OxfordUniRacing/BSPD_ECAD/BSPD.pdf

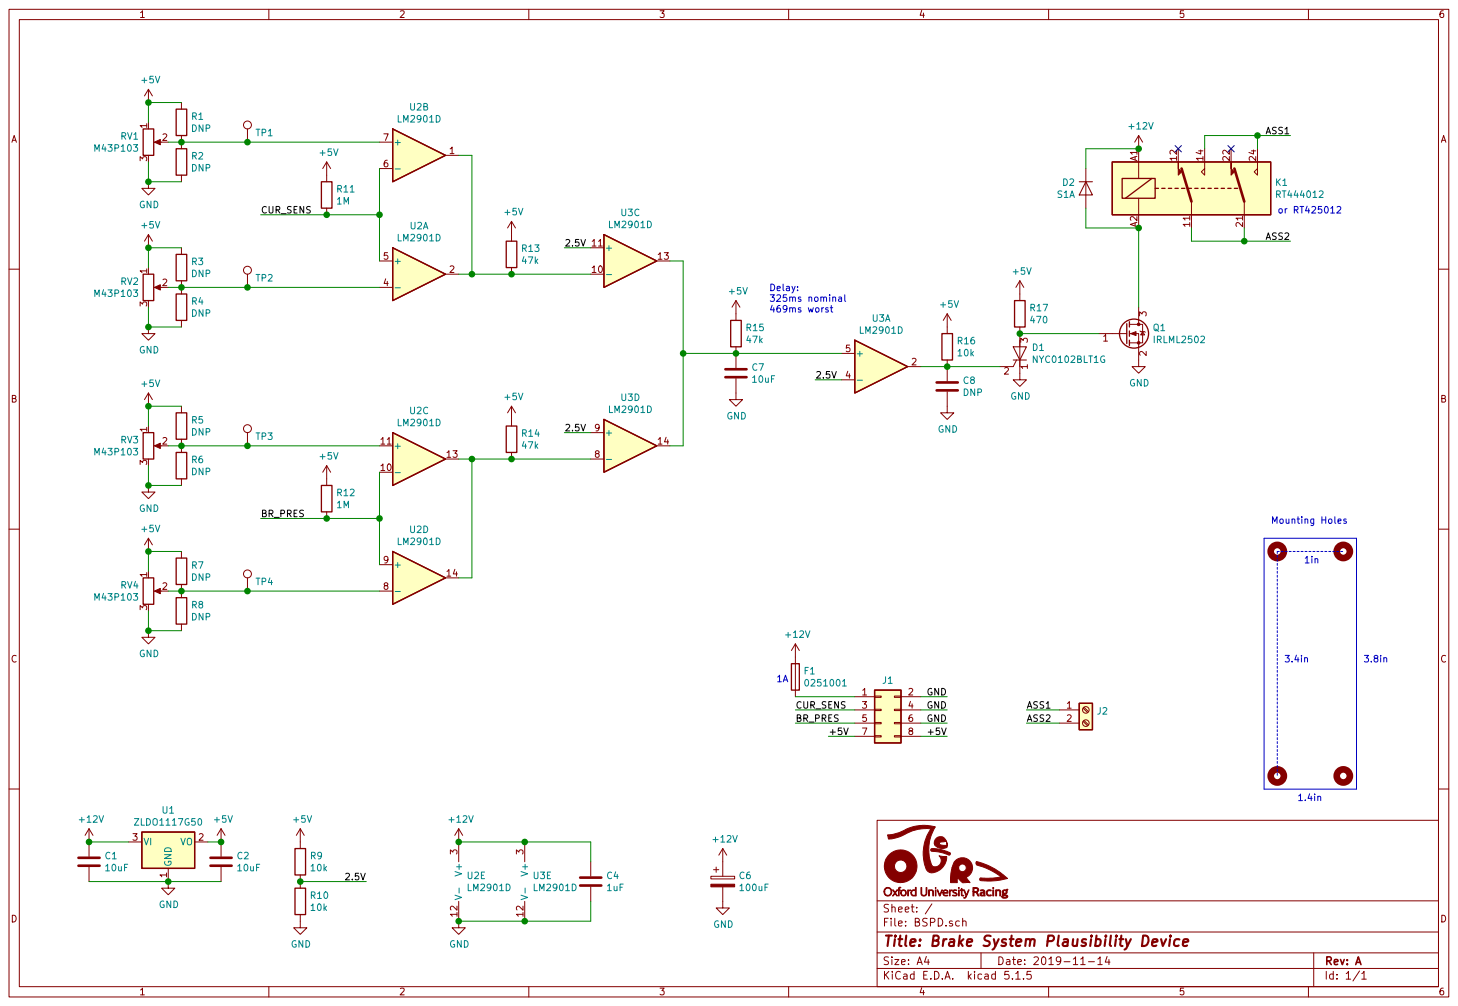
[picture p1: page 1]

3.8in Mounting Holes 1A Delay: 325ms nominal 469ms worst

File: BSPD.sch Sheet: /
Id: 1/1 Title: Brake System Plausibility Device
