OxfordUniRacing/BSPD_ECAD/assembly.pdf

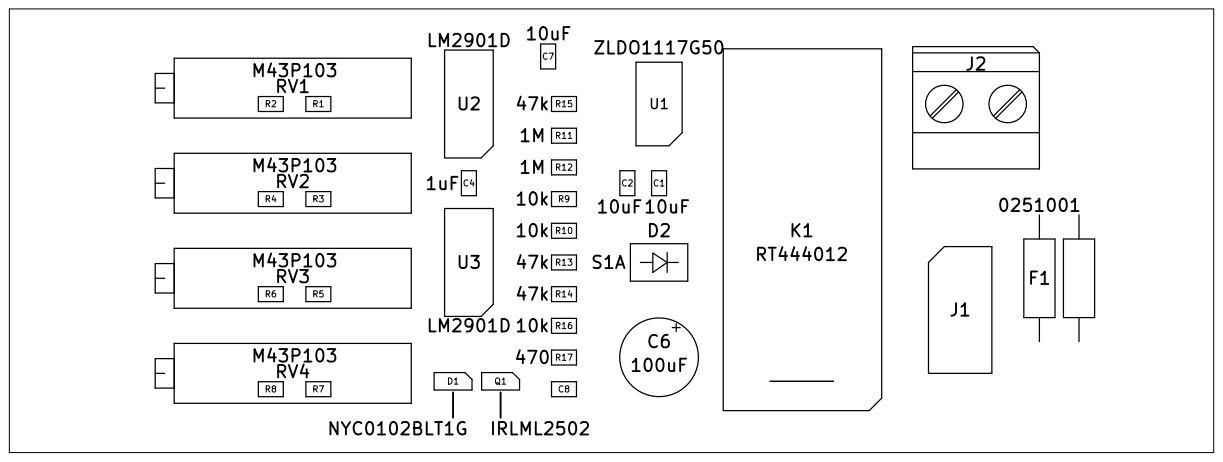
[picture p2: page 1]
