OxfordUniRacing/BSPD_ECAD/BSPD.kicad_pcb

## KiCad design BSPD.kicad_pcb (2019-12-31)

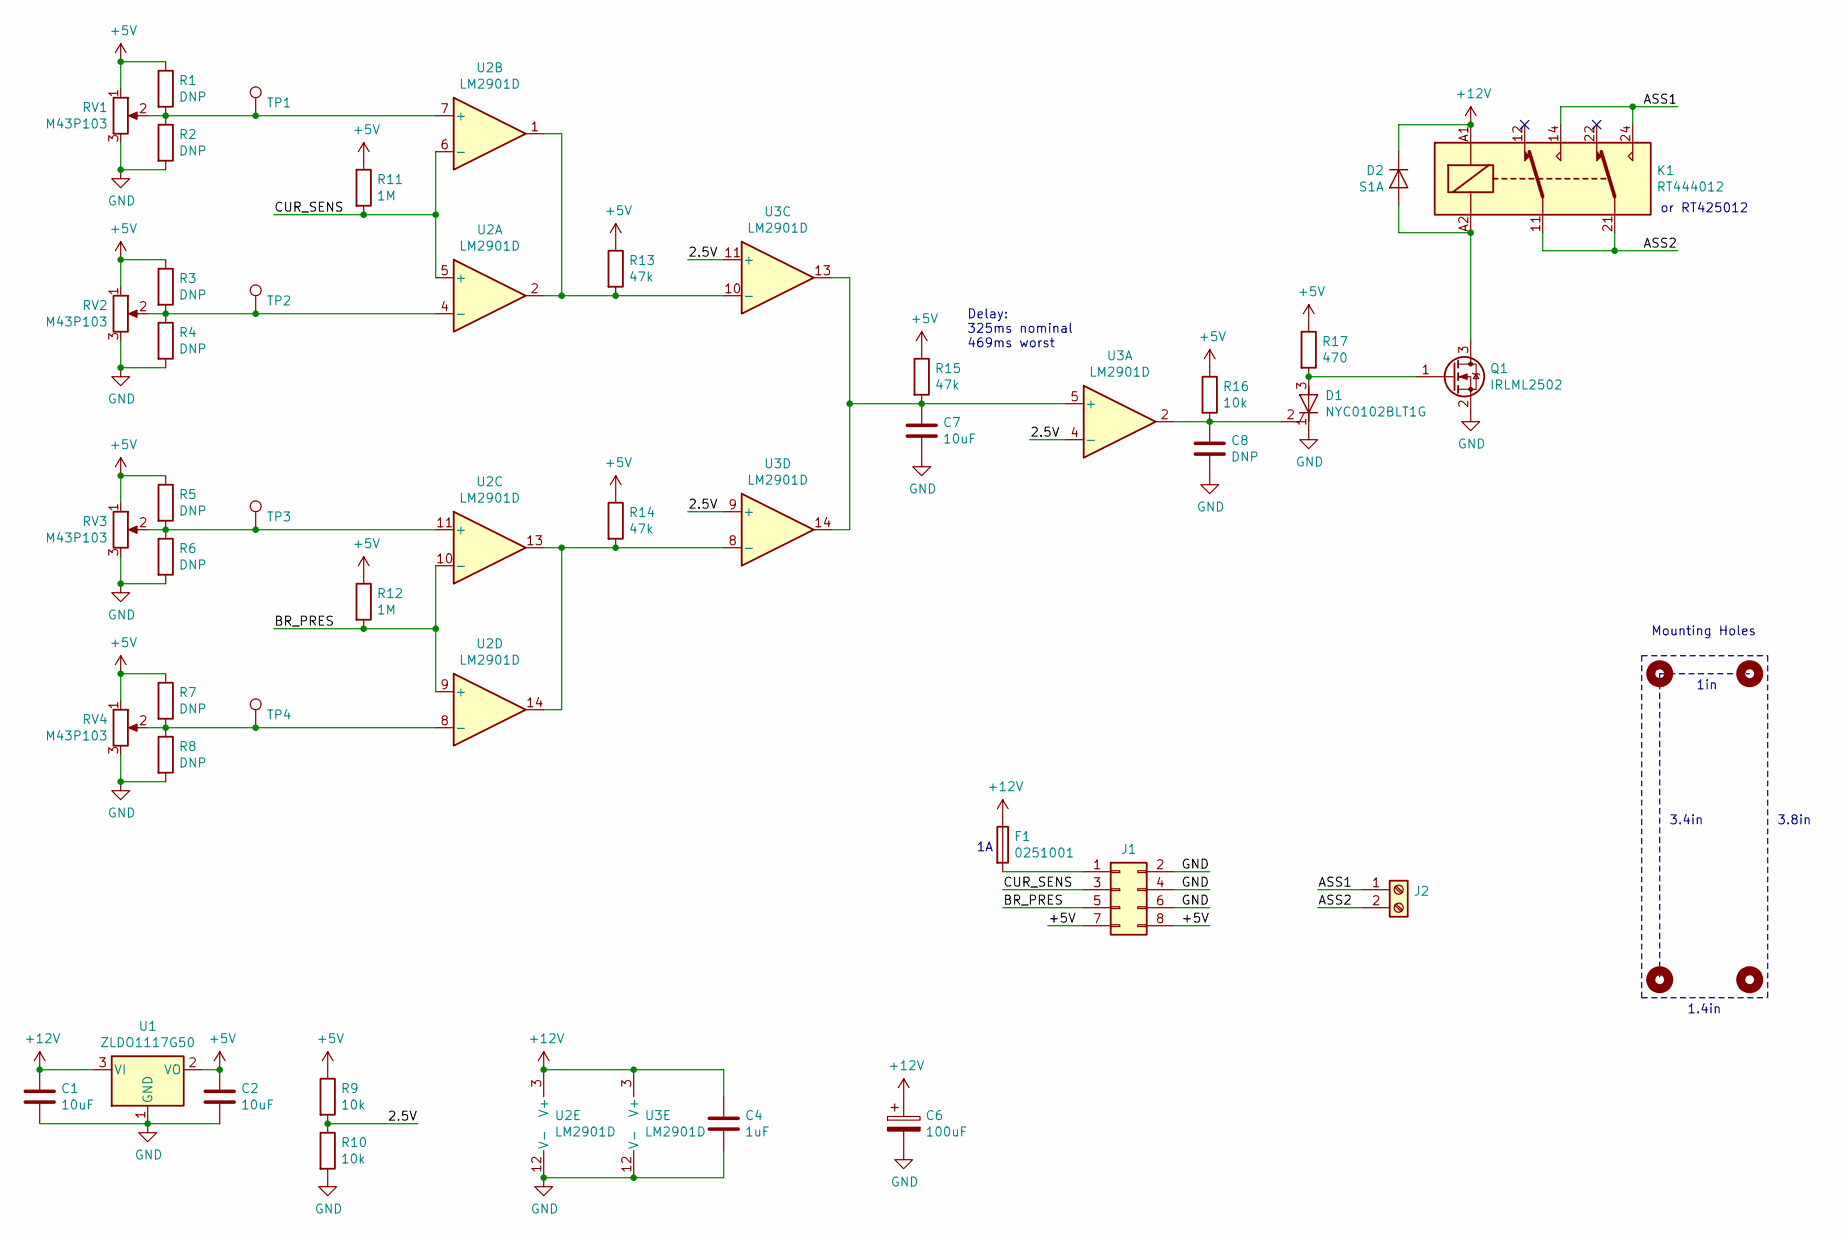
[picture p3: schematic BSPD.sch, Brake System Plausibility Device]

Parts:
C1, C2, C7: 10uF; C_0805_2012Metric_Pad1.15x1.40mm_HandSolder
C4: 1uF; C_0805_2012Metric_Pad1.15x1.40mm_HandSolder
C6: 100uF; CP_Radial_D6.3mm_P2.50mm
C8: DNP; C_0805_2012Metric_Pad1.15x1.40mm_HandSolder
D1: NYC0102BLT1G; SOT-23_Handsoldering
D2: S1A; D_SMA_Handsoldering
F1: 0251001; R_Axial_DIN0207_L6.3mm_D2.5mm_P10.16mm_Horizontal
H1, H2, H3, H4: MountingHole; MountingHole_3.2mm_M3_Pad
J1: Conn_02x04_Odd_Even; PinHeader_2x04_P2.54mm_Vertical_Shrouded
J2: Screw_Terminal_01x02; TerminalBlock_Phoenix_MKDS-1,5-2-5.08_1x02_P5.08mm_Horizont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
K1: RT444012; Relay_DPDT_Schrack-RT2-FormC_RM5mm
Q1: IRLML2502; SOT-23_Handsoldering
R1, R2, R3, R4, R5, R6, R7, R8: DNP; R_0805_2012Metric_Pad1.15x1.40mm_HandSolder
R9, R10, R16: 10k; R_0805_2012Metric_Pad1.15x1.40mm_HandSolder
R11, R12: 1M; R_0805_2012Metric_Pad1.15x1.40mm_HandSolder
R13, R14, R15: 47k; R_0805_2012Metric_Pad1.15x1.40mm_HandSolder
R17: 470; R_0805_2012Metric_Pad1.15x1.40mm_HandSolder
RV1, RV2, RV3, RV4: M43P103; Potentiometer_Vishay_43_Horizontal
TP1, TP2, TP3, TP4: TestPoint; TestPoint_Pad_D1.5mm
U1: ZLDO1117G50; SOT-223-3_TabPin2
U2, U3: LM2901D; SOIC-14_3.9x8.7mm_P1.27mm

Connections:
+5V: C2.1, J1.7, J1.8, R1.1, R3.1, R5.1, R7.1, R9.1, R11.1, R12.1, R13.1, R14.1, R15.1, R16.1, R17.1, RV1.1, RV2.1, RV3.1, RV4.1, U1.2 (VO)
+12V: C1.1, C4.1, C6.1, D2.1 (K), F1.1, K1.A1, U1.3 (VI), U2.3 (V+), U3.3 (V+); also elsewhere on the board
/2.5V: R9.2, R10.1, U3.4 (-), U3.9 (+), U3.11 (+)
/ASS1: J2.1, K1.14, K1.24
/ASS2: J2.2, K1.11, K1.21
/BR_PRES: J1.5, R12.2, U2.9 (+), U2.10 (-)
/CUR_SENS: J1.3, R11.2, U2.5 (+), U2.6 (-)
GND: C1.2, C2.2, C4.2, C6.2, C7.2, C8.2, D1.1 (K), J1.2, J1.4, J1.6, Q1.2 (S), R2.2, R4.2, R6.2, R8.2, R10.2, RV1.3, RV2.3, RV3.3, RV4.3, U1.1 (GND), U2.12 (V-), U3.12 (V-)
unnamed: C7.1, R15.2, U3.5 (+), U3.13, U3.14
unnamed: C8.1, D1.2 (G), R16.2, U3.2
unnamed: D1.3 (A), Q1.1 (G), R17.2
unnamed: D2.2 (A), K1.A2, Q1.3 (D)
unnamed 12: F1.2, J1.1; also elsewhere on the board
unnamed: R1.2, R2.1, RV1.2, TP1.1, U2.7 (+)
unnamed: R3.2, R4.1, RV2.2, TP2.1, U2.4 (-)
unnamed: R5.2, R6.1, RV3.2, TP3.1, U2.11 (+)
unnamed: R7.2, R8.1, RV4.2, TP4.1, U2.8 (-)
unnamed: R13.2, U2.1, U2.2, U3.10 (-)
unnamed: R14.2, U2.13, U2.14, U3.8 (-)

Notes on the sheet:
Delay: 325ms nominal 469ms worst
or RT425012
3.4in
1in
1.4in
3.8in
Mounting Holes

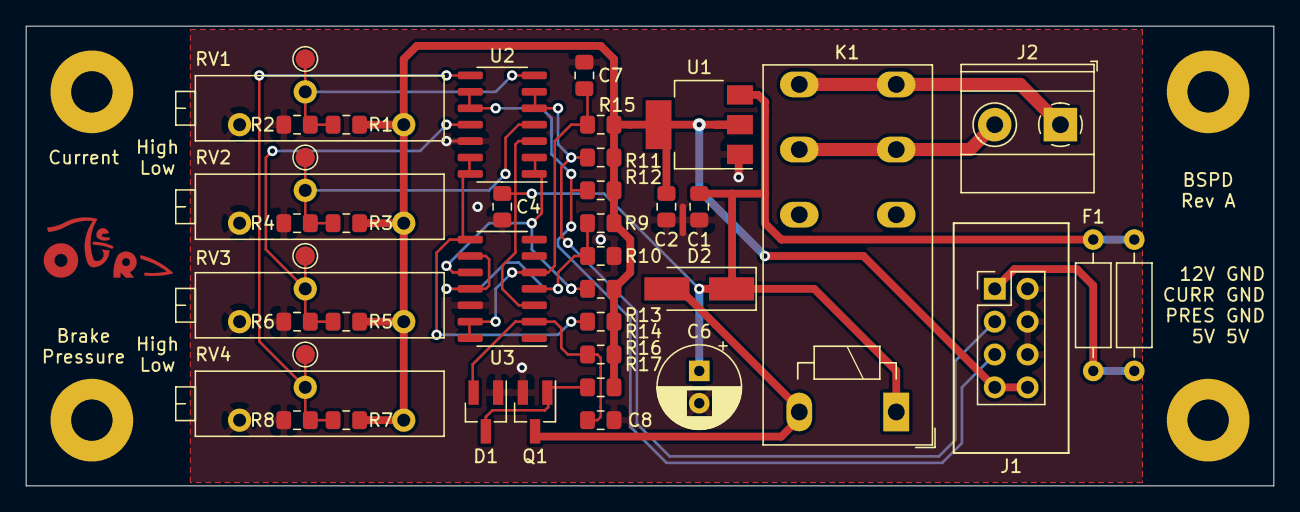
[picture p4: board BSPD.kicad_pcb from above]

Board: 2 copper layers, 96.5 x 35.6 mm, 46 parts (0 on the bottom side), 19 nets.

Other parts of the board:
F1#2: 0251001; R_Axial_DIN0207_L6.3mm_D2.5mm_P10.16mm_Horizontal

Their connections:
+12V: F1#2.1; also elsewhere on the board
unnamed 12: F1#2.2; also elsewhere on the board
