OxfordUniRacing/BSPD_ECAD/(commit log)

2019-11-14 rev a
    [BSPD-B_Cu.gbr, BSPD-B_Mask.gbr, BSPD-B_SilkS.gbr, BSPD-Edge_Cuts.gbr, BSPD-F_Cu.gbr, BSPD-F_Mask.gbr, BSPD-F_SilkS.gbr, BSPD-NPTH-drl_map.gbr]
2019-11-15 add logo
    [BSPD-B_Cu.gbr, BSPD-B_Mask.gbr, BSPD-B_SilkS.gbr, BSPD-Edge_Cuts.gbr, BSPD-F_Cu.gbr, BSPD-F_Mask.gbr, BSPD-F_SilkS.gbr, BSPD-NPTH-drl_map.gbr]
2019-12-31 update schematics
    Change regulator to ZLDO1117
    [BSPD.kicad_pcb, BSPD.sch]
2021-11-17 Added raw BOM export
    [BSPD_bom.csv]
